dpozimski/smart-hamster-cage/Board/Parts.docx

Power supply connector

https://botland.com.pl/przewody-i-zlacza-zasilajace/411-gniazdo-dc-55-x-21-mm-do-druku.html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

Unipolar step motot driver

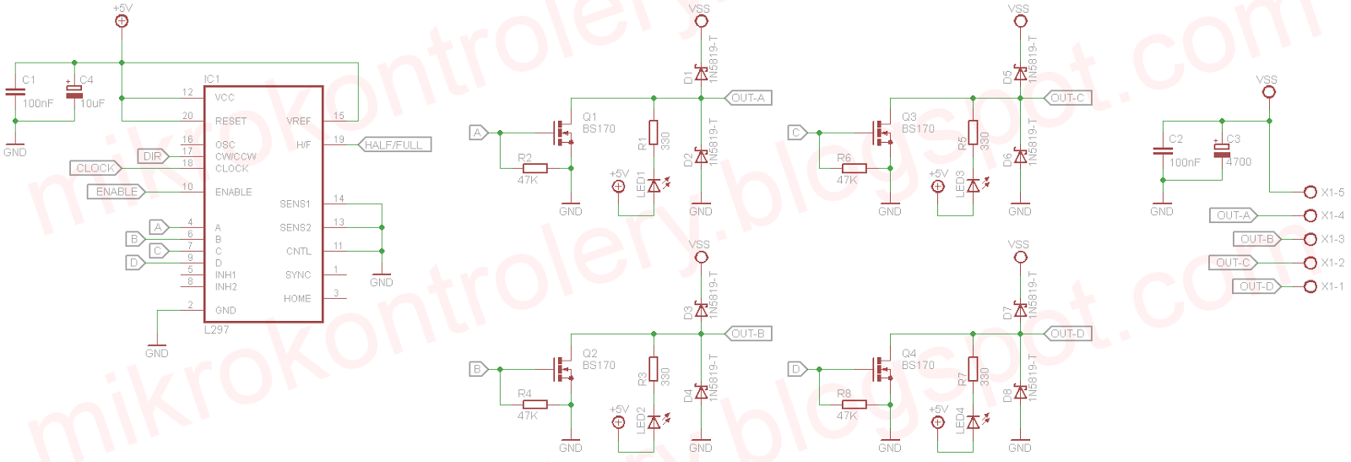
[picture p5: figure]
