dpozimski/smart-hamster-cage/Board/board.brd

## EAGLE design Board/board.brd (2018-05-04)

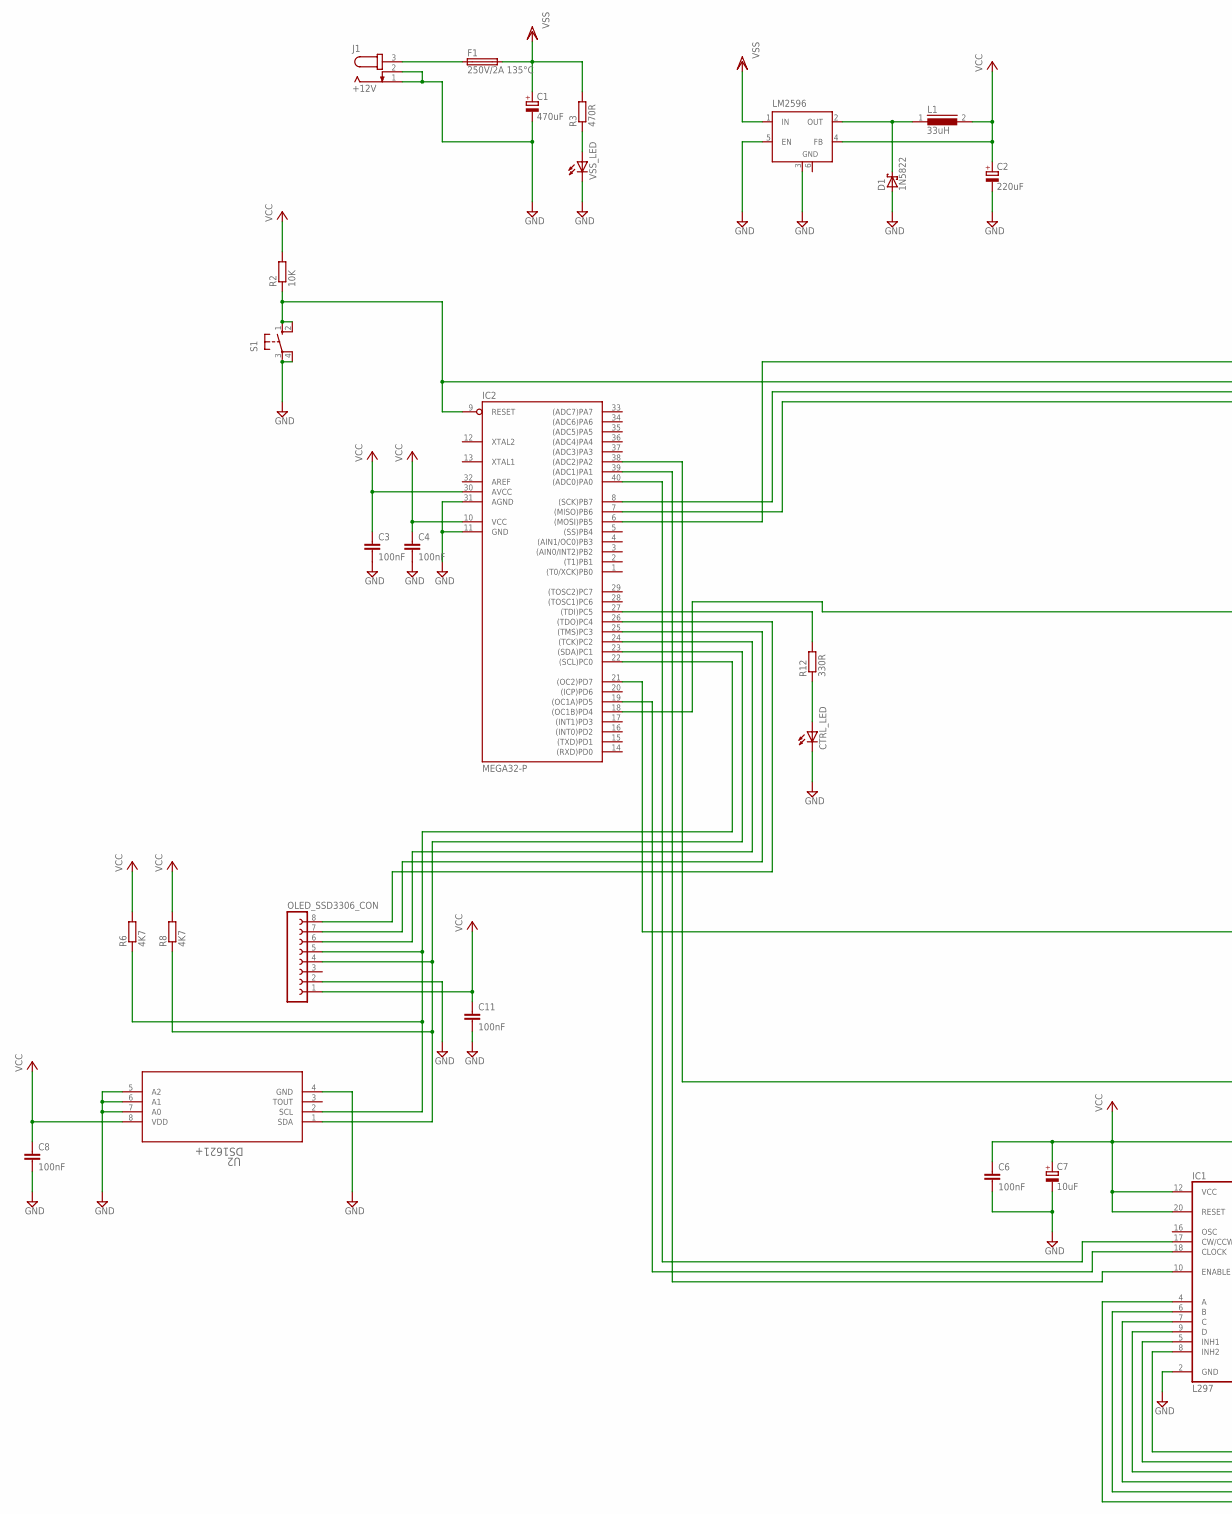
[picture p6: schematic board.sch, part in row 1, column 1]

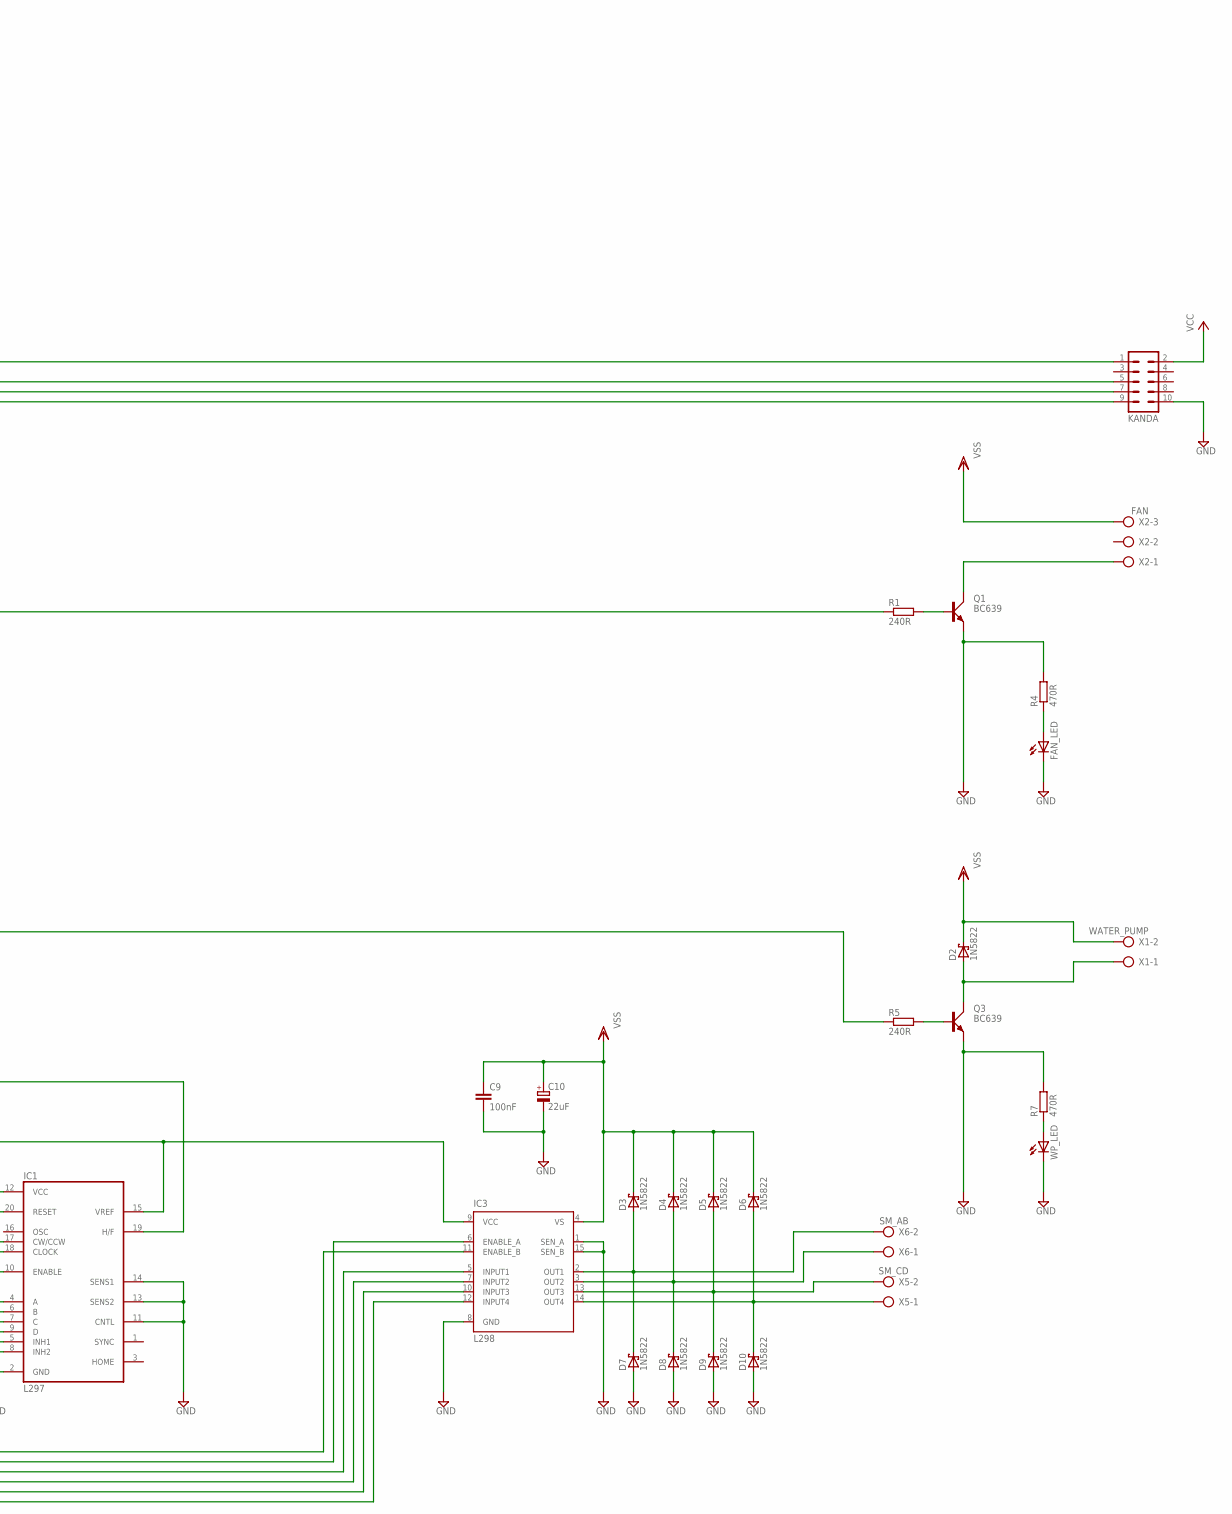
[picture p7: schematic board.sch, part in row 1, column 2]

Parts:
C1: 470uF; E5-10,5
C2: 220uF; E5-10,5
C3, C4, C6, C8, C9, C11: 100nF; C025-025X050
C7: 10uF; E5-10,5
C10: 22uF; E5-10,5
CTRL_LED: LED5MM
D1, D2, D3, D4, D5, D6, D7, D8, D9, D10: 1N5822; DO41-7.6
F1: 250V/2A 135°C; 19560
FAN_LED: LED5MM
IC1: L297; DIL20
IC2: MEGA32-P; DIL40
IC3: L298; MULTIWATT-15
J1: +12V; SPC4078
KANDA: ML10
L1: 33uH; BC12
LM2596: LM2596S; TO263-5
OLED_SSD3306_CON: FE08-1; FE08
Q1, Q3: BC639; SOT54D
R1, R5: 240R; 0207/12
R2: 10K; 0207/12
R3, R4, R7: 470R; 0207/12
R6, R8: 4K7; 0207/12
R12: 330R; 0207/12
S1: 10-XX; B3F-10XX
U2: DS1621+; 21-0043D_8
VSS_LED: LED5MM
WP_LED: LED5MM
X1: WATER_PUMP; AK500/2
X2: FAN; AK500/3
X5: SM_CD; AK500/2
X6: SM_AB; AK500/2

Connections:
AREF: IC2.32 (AREF)
GND: C1.-, C2.-, C3.2, C4.2, C6.2, C7.-, C8.2, C9.2, C10.-, C11.2, CTRL_LED.K (C), D1.A, D7.A, D8.A, D9.A, D10.A, FAN_LED.K (C), IC1.2 (GND), IC1.11 (CNTL), IC1.13 (SENS2), IC1.14 (SENS1), IC2.11 (GND), IC2.31 (AGND), IC3.1 (SEN_A), IC3.8 (GND), IC3.15 (SEN_B), J1.1, J1.2, KANDA.10, LM2596.3 (GND), LM2596.5 (EN), LM2596.6 (GND), OLED_SSD3306_CON.2, Q1.E, Q3.E, R4.2, R7.2, S1.3, S1.4 (P1), U2.4 (GND), U2.5 (A2), U2.6 (A1), U2.7 (A0), VSS_LED.K (C), WP_LED.K (C)
unnamed: F1.1, J1.3
unnamed: D1.C, L1.1, LM2596.2 (OUT)
unnamed: IC2.6 ((MOSI)PB5), KANDA.1
unnamed: IC2.8 ((SCK)PB7), KANDA.7
unnamed: IC2.7 ((MISO)PB6), KANDA.9
unnamed: R3.1, VSS_LED.A
unnamed: Q1.B, R1.2
unnamed: Q1.C, X2.1
unnamed: IC2.9 (RESET), KANDA.5, R2.1, S1.1 (S), S1.2 (S1)
unnamed: IC2.27 ((TDI)PC5), R12.2
unnamed: IC2.21 ((OC2)PD7), R5.1
unnamed: IC1.9 (D), IC3.5 (INPUT1)
unnamed: CTRL_LED.A, R12.1
unnamed: IC1.5 (INH1), IC3.6 (ENABLE_A)
unnamed: IC1.4 (A), IC3.12 (INPUT4)
unnamed: IC1.17 (CW/CCW), IC2.40 ((ADC0)PA0)
unnamed: IC1.18 (CLOCK), IC2.19 ((OC1A)PD5)
unnamed: IC1.10 (ENABLE), IC2.39 ((ADC1)PA1)
unnamed: IC1.19 (H/F), IC2.38 ((ADC2)PA2)
unnamed: IC1.8 (INH2), IC3.11 (ENABLE_B)
unnamed: R7.1, WP_LED.A
unnamed: FAN_LED.A, R4.1
unnamed: D6.A, D10.C, IC3.14 (OUT4), X5.1
unnamed: D3.A, D7.C, IC3.2 (OUT1), X6.2
unnamed: D4.A, D8.C, IC3.3 (OUT2), X6.1
unnamed: D5.A, D9.C, IC3.13 (OUT3), X5.2
unnamed: Q3.B, R5.2
unnamed: D2.A, Q3.C, X1.1
unnamed: IC2.18 ((OC1B)PD4), R1.1
unnamed: IC2.23 ((SDA)PC1), OLED_SSD3306_CON.4, R8.1, U2.1 (SDA)
unnamed: IC2.22 ((SCL)PC0), OLED_SSD3306_CON.5, R6.1, U2.2 (SCL)
unnamed: IC2.24 ((TCK)PC2), OLED_SSD3306_CON.6
unnamed: IC2.25 ((TMS)PC3), OLED_SSD3306_CON.7
unnamed: IC2.26 ((TDO)PC4), OLED_SSD3306_CON.8
unnamed: IC1.7 (C), IC3.7 (INPUT2)
unnamed: IC1.6 (B), IC3.10 (INPUT3)
VCC: C2.+, C3.1, C4.1, C6.1, C7.+, C8.1, C11.1, IC1.12 (VCC), IC1.15 (VREF), IC1.20 (RESET), IC2.10 (VCC), IC2.30 (AVCC), IC3.9 (VCC), KANDA.2, L1.2, LM2596.4 (FB), OLED_SSD3306_CON.1, R2.2, R6.2, R8.2, U2.8 (VDD)
VSS: C1.+, C9.1, C10.+, D2.C, D3.C, D4.C, D5.C, D6.C, F1.2, IC3.4 (VS), LM2596.1 (IN), R3.2, X1.2, X2.3

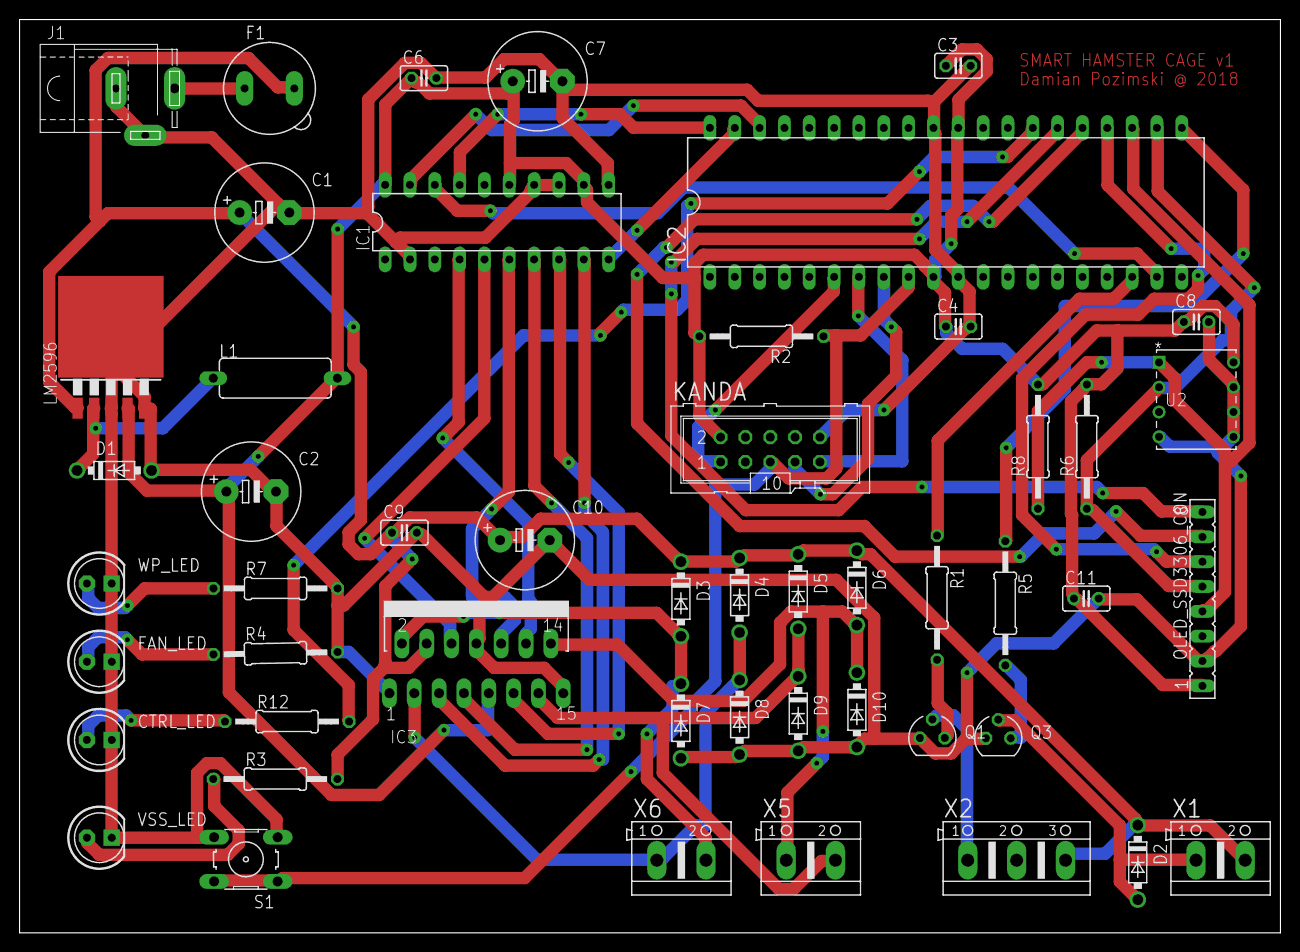
[picture p8: board board.brd from above]

Board: 2 copper layers, 129.0 x 93.4 mm, 50 parts (0 on the bottom side), 39 nets.
