dpozimski/smart-hamster-cage/Source/SmartHamsterCage/Flow/FoodFeedController.h

/*
 * FoodFeedController.h
 *
 * Created: 18.04.2018 21:09:02
 *  Author: d.pozimski
 */ 


#ifndef FOODFEEDCONTROLLER_H_
#define FOODFEEDCONTROLLER_H_

#include "Controller.h"
#include "./../Utils/OutputTimeRule.h"
#include "../Devices/StepperMotor.h"
#include <stdbool.h>

class FoodFeedController : public Controller
{
	public:
		FoodFeedController(StepperMotor* stepperMotor, OutputTimeRule* outputTimeRule);
        void update() override;
	private:
		StepperMotor* stepperMotor;
        OutputTimeRule* outputTimeRule;
};



#endif /* FOODFEEDCONTROLLER_H_ */
