dpozimski/smart-hamster-cage/(commit log)

2018-03-31 Power supply
    [board.brd, board.sch]
2018-04-02 MCU + Kanda input
    [board.sch]
2018-04-07 Fan, water pump, and supply for motor drive eagle
    [board.brd, board.sch]
2018-04-07 L297 to uC
    [board.brd, board.sch]
2018-04-07 Signal leds to connectors
    [board.brd, board.sch]
2018-04-08 stepper motor l298
    [board.brd, board.sch]
2018-04-08 added filter for vss l298
    [board.brd, board.sch]
2018-04-09 Added pcb design #1
    [board.brd, board.sch]
2018-04-09 auto route
    [board.brd, board.sch]
2018-04-09 added 5mm vss led
    [board.brd, board.sch]
2018-04-09 gnd line
    [board.brd]
2018-04-09 rc 1.0
    [board.brd, board.sch]
2018-04-10 Added I2C device class
2018-04-15 PWM devices code
    [board.brd, board.sch]
2018-04-15 Device as an abstract device
2018-04-15 steppermotor device
2018-04-15 ControlLed device
2018-04-17 wip i2c
2018-04-18 Temperature module support
2018-04-18 flow & uicontroller
2018-04-18 flow classes
2018-04-19 Timr0 as counter, Timer1 output b for fan
    [board.brd, board.sch]
2018-04-20 Added new inductor
    [board.brd, board.sch]
2018-04-20 Resistor value
    [board.brd, board.sch]
2018-04-21 SCL/SDA thermometer
    [board.brd, board.sch]
2018-04-21 Rename 1N5824 - 1N5822
    [board.brd, board.sch]
2018-04-22 AREF cannot be connected to VCC
    [board.brd, board.sch]
2018-04-27 10mil for corners
    [board.brd]
2018-04-29 Drill 0.5
    [board.brd]
2018-04-29 DRC rule for 0.5mm drill
    [board.brd]
2018-04-29 Diameter 1.3
    [board.brd]
2018-04-29 PWM devices checked
2018-04-29 Timer as normal input device
2018-04-29 Add i2c lib from github && i2c bus work for thermometer
2018-05-27 i2c mine implmentation im mk oled lib
2018-06-15 max pwm water pouring to 20
2018-06-16 PWM/time values changed for presentation
